RishitJain-dev/Flightime/README.md

# Flightime - Quadcopter




Flightime is a custom designed drone with a PLA Aero frame, 4 8520 brushed motors, and a PCB flight controller with a OV2640 camera mounted on the XIAO ESP32 S3 SENSE

> Weighs: 132.6g

I designed this as an example project for [Lift Off](liftoff-ysws.vercel.app), where you design a drone, and get the components to build it and if its a great project, then even a drone controller!

### Features
- OV2640 FPV Camera
- Bluetooth and WiFi capabilities
- < 150g
- Power Switch
- 8520 Brushed motors
- $200 total price (including tools!)

## PCB

The PCB was made in KiCAD! It has:
- GY-521 gyroscope
- XIAO ESP32 S3 sense
- Various resistors
- Various SMD & TH capacitors
- SMD MOFSETs




## CAD

The CAD was designed exclusively in Onshape. The 2 parts fit together with 4 M3 screws and nuts, it doesn't require any heatset inserts, you screw directly into the PLA.

There are cut-outs in each piece so that wires can fit through. This is a pusher drone, the motors are press fit and the propellers face towards the ground.



## Assembly  

Use the schematic diagram on Kicanvas to solder one side of the wires to the board before assembly. Then place the board, mount it using the screws and nuts and take the wires to the motors and solder the other side there. 

## Firmware

We move by slowing down certain motors and speeding up others, this causes it to lean and tilt towards the direction its meant to be going, and begins to accelerate. 
In the final firmware, it will be controlled through bluetooth on a computer or phone.



# Renders

Here are some renders I made in Onshape!
