RishitJain-dev/Flightime/Flightime - BOM.csv

Item Name | Qty | Price (total) (GBP) | Item link | Weight | Note
8520 Coreless Brushed Motors (8.5mm x 20mm, 3.7V) | 4 | $9.90 | https://www.amazon.co.uk/AOICRIE-Coreless-Brushed-Propeller-Quadcopter/dp/B0FPFNM7HM | 20
Lithium Polymer Battery 3.7V 500mAh | 1 | $22.00 | https://www.amazon.co.uk/dp/B0CQKXNT8L?social_share=cm_sw_r_ud_dp_F21QHTZB00600W776FN3&language=en-GB | 28 | ugh battery finding is hard
XIAO ESP32 S3 Sense | 1 | $14.50 | https://www.seeedstudio.com/XIAO-ESP32S3-Sense-p-5639.html | 8
DroneBuildr Zip tie / Cable tie (Pack of 20) | 20 | $0.75 | https://www.unmannedtechshop.co.uk/products/dronebuildr-zip-tie-cable-tie-pack-of-20?variant=56578202304893 | 1
GY-521 MPU-6050 Module | 1 | $4.99 | https://www.amazon.co.uk/DollaTek-MPU-6050-mpu6050-Accelerometer-Arduino/dp/B07DJ4KMBF | 4
3M Double-Sided Mounting Foam (2.5x2.5x2.5cm, Pack of 16) | 16 | $1.75 | https://www.unmannedtechshop.co.uk/products/3m-double-sided-mounting-foam-2-5x2-5x2-5cm-pack-of-16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 | 2
HQ Ultralight Prop 2X0.8X3 (51mm) Grey | 4 | $4.18 | https://www.unmannedtechshop.co.uk/products/51mmx0-8x3gr-1mm-pc-propeller | 1.6
M3 screws/nuts/washers | 1 | $6.49 | https://www.amazon.co.uk/Hexagon-Socket-Screws-Washers-Machine/dp/B0DQ3BYBLQ | 5 | A small kit!
Solid core wire | 2 | $3.00 | https://thepihut.com/products/wire-22awg-brown | 2
Resistors/diodes/capacitors/MOFSETs/switches kit | 1 | $20.00 | (multiple generic distributors) | 5
PCB | 1 | $8.00 | NA | 17
PLA Aero | 1 | $13.66 | https://uk.store.bambulab.com/products/pla-aero | 50
Heat shrink tubing | 1 | $6.00 | https://thepihut.com/products/265-piece-ultimate-heat-shrink-kit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 | 2
Mini Hot Plate + solder paste (No one can assemble the S3 SENSE) :cry | 1 | $50.00 | https://www.amazon.co.uk/Electric-Heating-Preheating-Station-Soldering/dp/B0H2M8T4NS | NA | genuinely the cheapest hot plate in my entire country (slow+reverb)
Cheap scale | 1 | $6.00 | https://www.amazon.co.uk/Digital-Jewellery-Weighing-New-Horrizon/dp/B08813G3VS | NA
Total Price (GBP): | $196.22 |  | Total weight (g): | 145.6
Total Price (USD): | $225.30
