RishitJain-dev/Flightime/Production/bom.csv

Designator | Footprint | Quantity | Value | LCSC Part #
 |  | 1
C1 | CP_Radial_D6.3mm_P2.50mm | 1 | 220uF_10V
C2 | 0603 | 1 | 0.1uF
D1, D2, D3, D4 | D_DO-35_SOD27_P7.62mm_Horizontal | 4 | 1N4148
J1, J2, J3, J4 | JST_EH_B2B-EH-A_1x02_P2.50mm_Vertical | 4 | JST_02
J5, J6 | JST_EH_B2B-EH-A_1x02_P2.50mm_Vertical | 2 | Conn_01x02_Pin
Q1, Q2, Q3, Q4 | SOT-23 | 4 | AO3400A
R1, R2, R3, R4 | R_Axial_DIN0207_L6.3mm_D2.5mm_P10.16mm_Horizontal | 4 | 100ohm
R5, R6, R7, R8 | R_Axial_DIN0207_L6.3mm_D2.5mm_P10.16mm_Horizontal | 4 | 100k
SW1 | Nidec_Copal_CAS-120A | 1 | SW_Nidec_CAS-120A1
U1 | XIAO-ESP32-S3-SMD | 1 | XIAO-ESP32-S3-SMD
U2 | MODULE_GY-521 | 1 | GY-521
