RishitJain-dev/Flightime/CAD/mainbody (tpu 95a) - Part 1.step

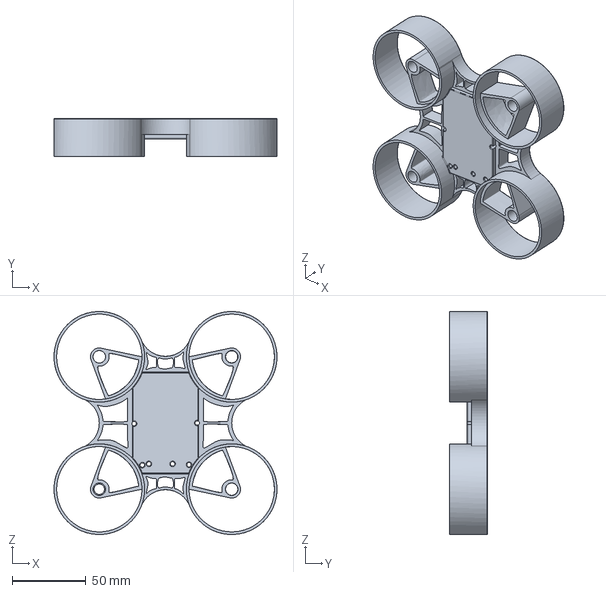
[picture p1: CAD file, 2026-10-22]
CAD/mainbody (tpu 95a) - Part 1.step
151.6 x 26.0 x 151.6 mm
