RishitJain-dev/Flightime/CAD/mainbody (tpu 95a) - Part 134.step

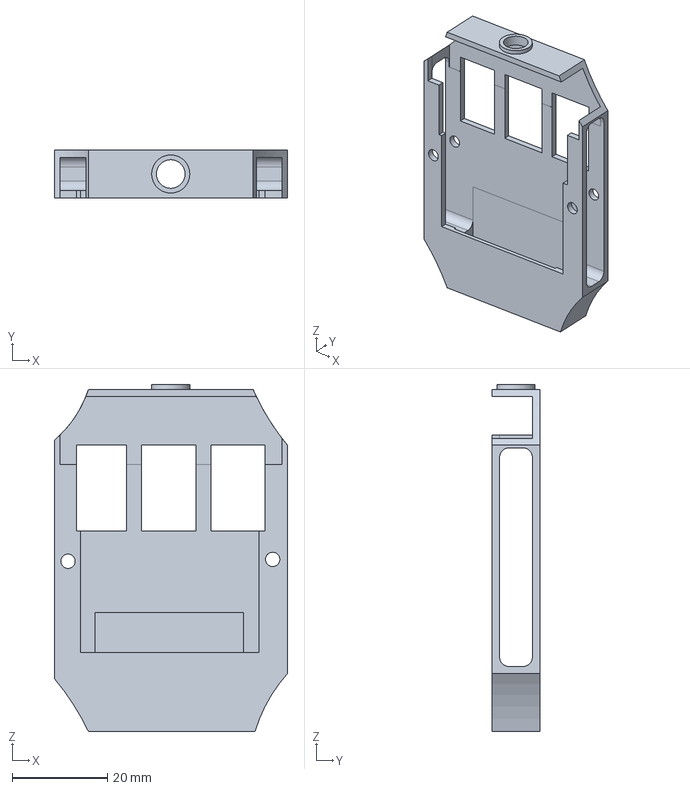
[picture p2: CAD file, 2026-10-22]
CAD/mainbody (tpu 95a) - Part 134.step
48.9 x 10.0 x 72.8 mm
