RishitJain-dev/Flightime/PCB/Flightime.kicad_pcb

## KiCad design PCB/Flightime.kicad_pcb (2026-10-23)

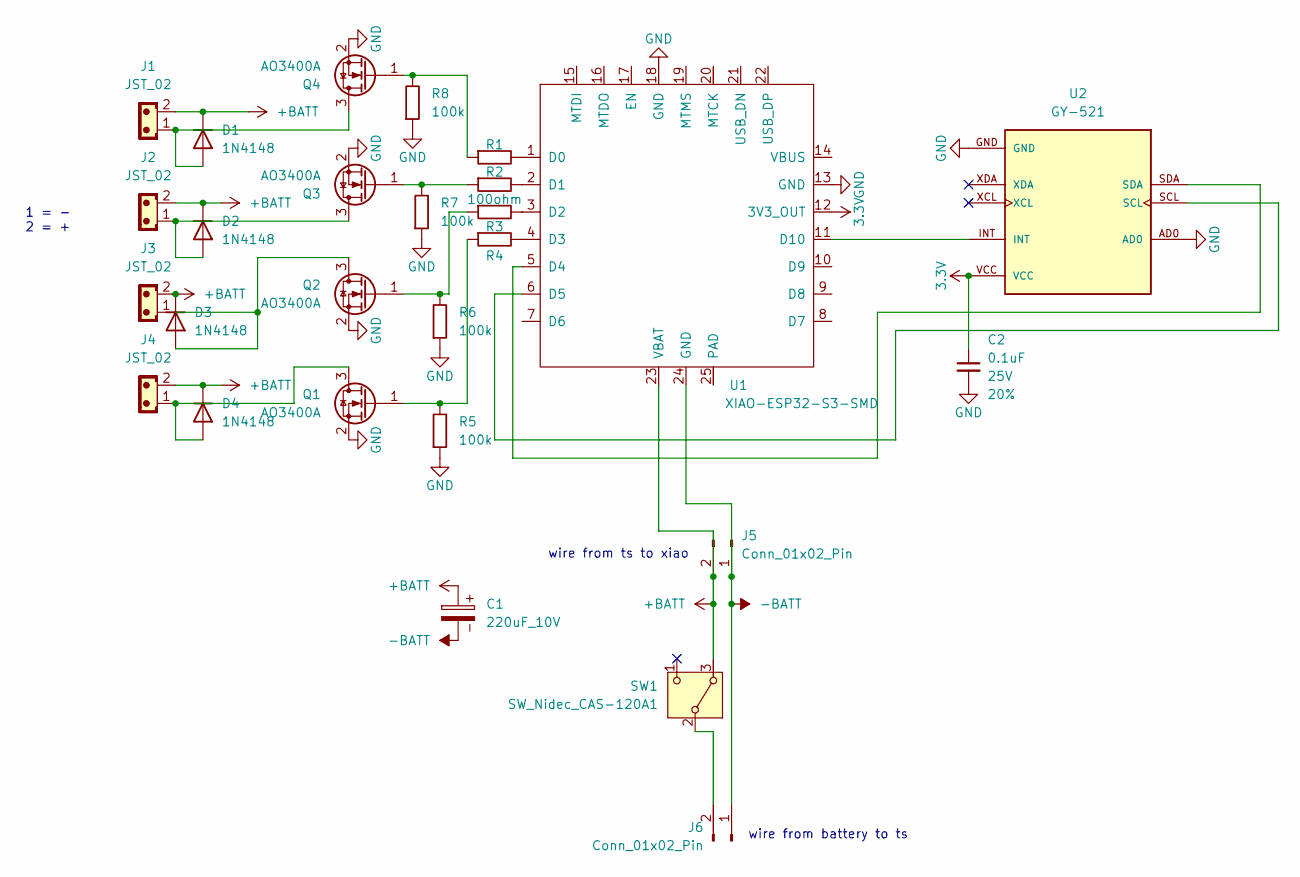
[picture p3: schematic Flightime.kicad_sch]

Parts:
C1: 220uF_10V; CP_Radial_D6.3mm_P2.50mm
C2: 0.1uF; C_0603_1608Metric; Voltage 25V; Tolerance 20%
D1, D2, D3, D4: 1N4148; D_DO-35_SOD27_P7.62mm_Horizontal
J1, J2, J3, J4: JST_02; JST_EH_B2B-EH-A_1x02_P2.50mm_Vertical
J5, J6: Conn_01x02_Pin; JST_EH_B2B-EH-A_1x02_P2.50mm_Vertical
Q1, Q2, Q3, Q4: AO3400A; SOT-23
R1, R2, R3, R4: 100ohm; R_Axial_DIN0207_L6.3mm_D2.5mm_P10.16mm_Horizontal
R5, R6, R7, R8: 100k; R_Axial_DIN0207_L6.3mm_D2.5mm_P10.16mm_Horizontal
SW1: SW_Nidec_CAS-120A1; Nidec_Copal_CAS-120A
U1: XIAO-ESP32-S3-SMD
U2: GY-521; MODULE_GY-521; PARTREV NA

Connections:
3.3V: C2.1, U1.12 (3V3_OUT), U2.VCC
-BATT: C1.2, J5.1, J6.1, U1.24 (GND)
GND: C2.2, Q1.2 (S), Q2.2 (S), Q3.2 (S), Q4.2 (S), R5.1, R6.1, R7.1, R8.1, U1.13 (GND), U1.18 (GND), U2.AD0, U2.GND
unnamed: D1.2 (A), J1.1, Q4.3 (D)
unnamed: D2.2 (A), J2.1, Q3.3 (D)
unnamed: D3.2 (A), J3.1, Q2.3 (D)
unnamed: D4.2 (A), J4.1, Q1.3 (D)
unnamed: Q1.1 (G), R4.1, R5.2
unnamed: Q2.1 (G), R3.1, R6.2
unnamed: Q3.1 (G), R2.1, R7.2
unnamed: Q4.1 (G), R1.1, R8.2
unnamed: R1.2, U1.1 (D0)
unnamed: R2.2, U1.2 (D1)
unnamed: R3.2, U1.3 (D2)
unnamed: R4.2, U1.4 (D3)
unnamed: U1.5 (D4), U2.SDA
unnamed: U1.6 (D5), U2.SCL
unnamed: U1.11 (D10), U2.INT

Notes on the sheet:
wire from ts to xiao
wire from battery to ts
1 = - 2 = +

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
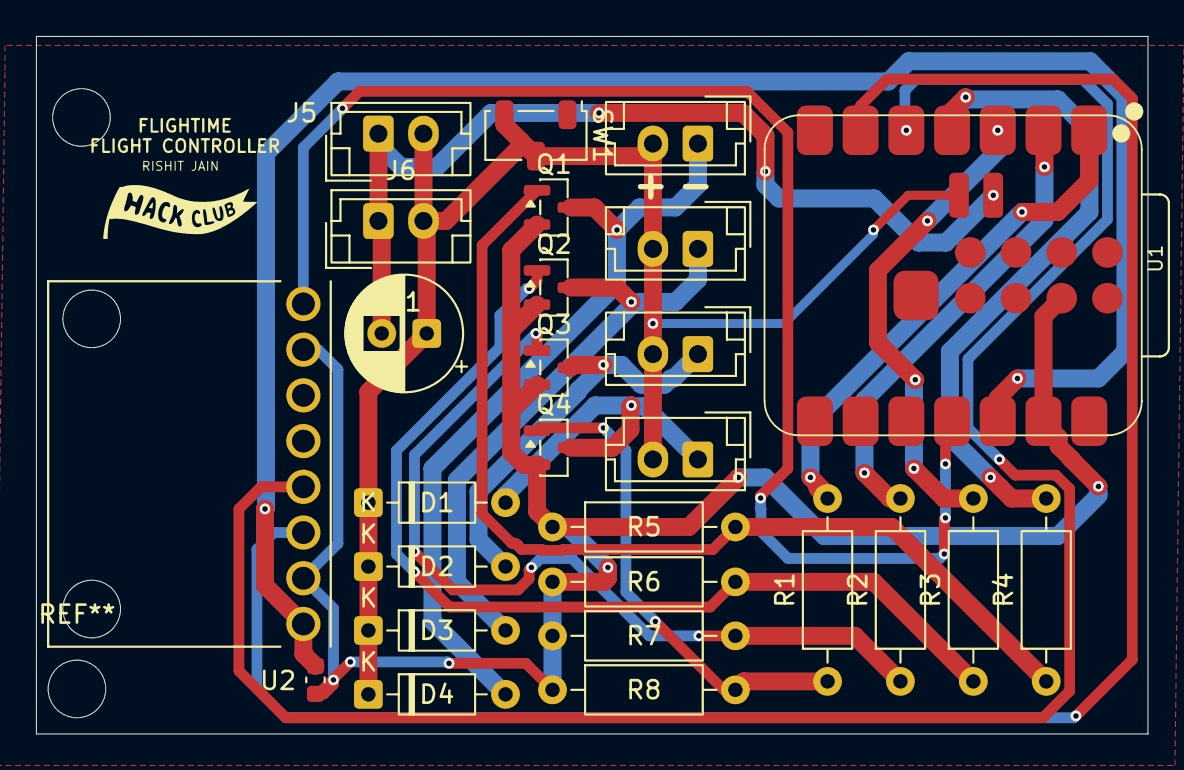
[picture p4: board Flightime.kicad_pcb from above]

Board: 2 copper layers, 61.8 x 38.8 mm, 27 parts (0 on the bottom side), 19 nets.
