RishitJain-dev/Flightime/Firmware/firmware.ino

#include <Wire.h>
#include "esp_camera.h"

#define PWDN_GPIO_NUM     -1
#define RESET_GPIO_NUM    -1
#define XCLK_GPIO_NUM     10
#define SIOD_GPIO_NUM     40
#define SIOC_GPIO_NUM     39

#define Y9_GPIO_NUM       48
#define Y8_GPIO_NUM       11
#define Y7_GPIO_NUM       12
#define Y6_GPIO_NUM       14
#define Y5_GPIO_NUM       16
#define Y4_GPIO_NUM       42
#define Y3_GPIO_NUM       41
#define Y2_GPIO_NUM       38
#define VSYNC_GPIO_NUM    47
#define HREF_GPIO_NUM     27
#define PCLK_GPIO_NUM     13

// ^ i did use ai to help we w/ ts i have lowkenuinely never defined variables like this b4 ^

const int MPU_addr = 0x68; 

const int motorPins[4] = {1, 2, 3, 4};

void setup() {
  Serial.begin(115200);
  while (!Serial); 
  for (int i = 0; i < 4; i++) {
    pinMode(motorPins[i], OUTPUT);
    digitalWrite(motorPins[i], LOW);
  }
  Serial.println("Motors initialized to OFF.");

  Wire.begin(8, 9);
  Wire.beginTransmission(MPU_addr);
  Wire.write(0x6B); 
  Wire.write(0);    
  Wire.endTransmission(true);
  Serial.println("MPU-6050 initialized.");

  camera_config_t config;
  config.ledc_channel = LEDC_CHANNEL_0;
  config.ledc_timer = LEDC_TIMER_0;
  config.pin_d0 = Y2_GPIO_NUM;
  config.pin_d1 = Y3_GPIO_NUM;
  config.pin_d2 = Y4_GPIO_NUM;
  config.pin_d3 = Y5_GPIO_NUM;
  config.pin_d4 = Y6_GPIO_NUM;
  config.pin_d5 = Y7_GPIO_NUM;
  config.pin_d6 = Y8_GPIO_NUM;
  config.pin_d7 = Y9_GPIO_NUM;
  config.pin_xclk = XCLK_GPIO_NUM;
  config.pin_pclk = PCLK_GPIO_NUM;
  config.pin_vsync = VSYNC_GPIO_NUM;
  config.pin_href = HREF_GPIO_NUM;
  config.pin_sccb_sda = SIOD_GPIO_NUM;
  config.pin_sccb_scl = SIOC_GPIO_NUM;
  config.pin_pwdn = PWDN_GPIO_NUM;
  config.pin_reset = RESET_GPIO_NUM;
  config.xclk_freq_hz = 20000000;
  config.frame_size = FRAMESIZE_QVGA;
  config.pixel_format = PIXFORMAT_JPEG; 
  config.grab_mode = CAMERA_GRAB_LATEST;
  config.fb_location = CAMERA_FB_IN_PSRAM;
  config.jpeg_quality = 12;
  config.fb_count = 1;

  esp_err_t err = esp_camera_init(&config);
  if (err != ESP_OK) {
    Serial.printf("Camera initialization failed with error 0x%x\n", err);
  } else {
    Serial.println("Camera initialized successfully!");
  }
}

void loop() {
  Wire.beginTransmission(MPU_addr);
  Wire.write(0x3B); 
  Wire.endTransmission(false);
  Wire.requestFrom(MPU_addr, 6, true);

  int16_t ax = (Wire.read() << 8 | Wire.read());
  int16_t ay = (Wire.read() << 8 | Wire.read());
  int16_t az = (Wire.read() << 8 | Wire.read());

  Serial.print("Accel -> X: "); Serial.print(ax);
  Serial.print(" | Y: "); Serial.print(ay);
  Serial.print(" | Z: "); Serial.println(az);

  camera_fb_t * fb = esp_camera_fb_get();
  if (!fb) {
    Serial.println("Camera capture failed");
  } else {
    Serial.printf("Camera frame captured! Size: %u bytes\n", fb->len);
    esp_camera_fb_return(fb); 
  }

  Serial.println("Turning motors ON...");
  for (int i = 0; i < 4; i++) {
    digitalWrite(motorPins[i], HIGH):
  }
  delay(500); 

  Serial.println("Turning motors OFF...");
  for (int i = 0; i < 4; i++) {
    digitalWrite(motorPins[i], LOW);
  }

  delay(2000);
}
