RishitJain-dev/Flightime/(commit log)

2026-10-22 pcb/production files
    [Flightime.kicad_pcb, Flightime.kicad_sch, bom.csv, designators.csv, positions.csv]
2026-10-22 cad imports
    [mainbody (tpu 95a) - Part 1.step, mainbody (tpu 95a) - Part 134.step]
2026-10-22 Enhance README with project details and features
    Updated the README to include detailed project description, features, and PCB information.
2026-10-22 Enhance README with CAD, Assembly, and Firmware details
    Added sections for CAD, Assembly, and Firmware to the README.
2026-10-22 removed wrong bom
    [Lift Off BOM - Sheet1.csv]
2026-10-22 Update Lift Off BOM - Sheet1 (1).csv
    [Lift Off BOM - Sheet1 (1).csv]
2026-10-23 reorientazted s3
    [Flightime.kicad_pcb, Flightime.kicad_sch, positions.csv]
2026-11-06 Add Flightime BOM to project
2026-11-06 Update Flightime BOM
2026-11-06 removed excess bom
2026-11-07 update bom
    [Flightime - BOM.csv]
2026-11-09 Update Flightime BOM with new items and prices
    [Flightime - BOM.csv]
2026-11-09 Update Flightime BOM with new item entries
    [Flightime - BOM.csv]
